mprat99/IoT_Awnings/IoT_Awnings_Electronics_Schematic.pdf

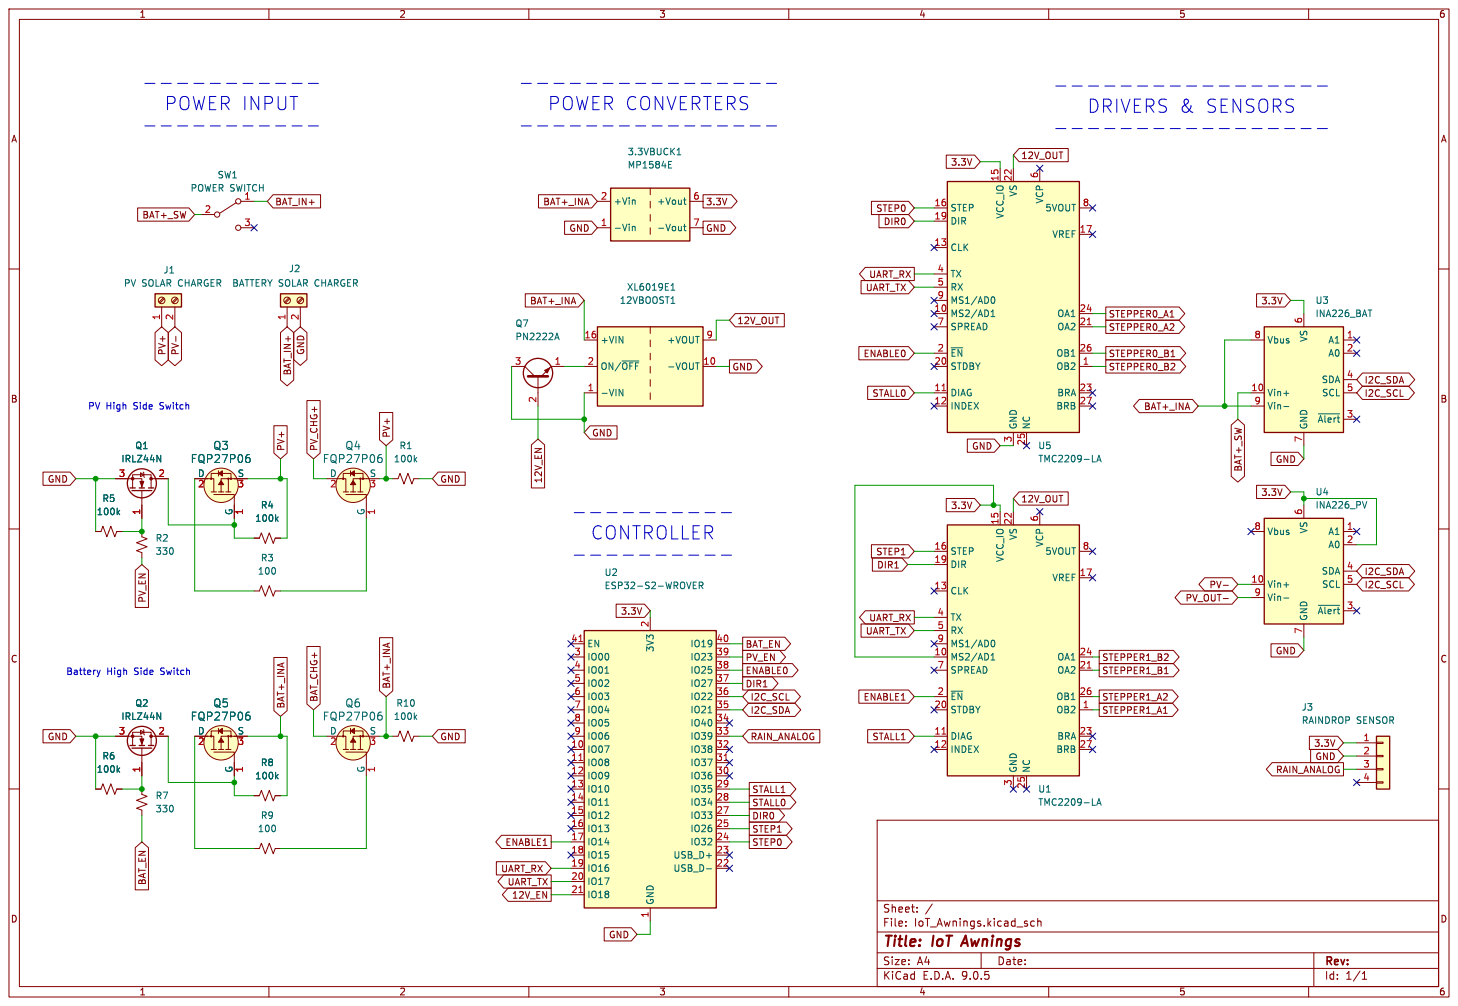
[picture p1: page 1]

STEP 16 DIR 19 CLK 13 TX 4 RX 5 MS1/AD0 9 MS2/AD1 10 SPREAD 7 ~{EN} 2 STDBY 20 DIAG 11

5VOUT 8 VREF 17 OA1 24 OA2 21 OB1 26 OB2 1 BRA 23 BRB 27 U1 TMC2209-LA

Id: 1/1 Title: IoT Awnings
