mprat99/IoT_Awnings/iot_awnings.ino

// =======================
// Includes
// =======================
#include <WiFi.h>
#include <AsyncTCP.h>
#include <ESPAsyncWebServer.h>
#include <time.h>
#include <ArduinoJson.h>
#include <FastAccelStepper.h>
#include <TMCStepper.h>
#include <EEPROM.h>
#include <Preferences.h>
#include <WiFiClient.h>
#include <ESPmDNS.h>
#include <Wire.h>
#include <INA226_WE.h>
#include "LittleFS.h"
#include <Update.h>
#include "esp_log.h"
#include <SolarCalculator.h>
#include <Ticker.h>



// =======================
// Pin Definitions (Updated)
// =======================

// Stepper 0
#define STEP0 32
#define DIR0 33
#define ENABLE0 25
#define STALL0 34
#define UART_ADDR0 0

// Stepper 1
#define STEP1 26
#define DIR1 27
#define ENABLE1 14
#define STALL1 35
#define UART_ADDR1 2

// ESP32 UART pins for TMC UART
#define UART_RX 16
#define UART_TX 17

// Boost converter (XL6019) enable (BJT base)
#define OUTPUT_12V_EN 18

// Solar charger control (kept HIGH, no logic)
#define PV_EN 23
#define BAT_EN 19

// Rain sensor
#define RAIN_PIN 39

// I2C pins
#define I2C_SDA 21
#define I2C_SCL 22

// =======================
// Hardware Configuration
// =======================
#define R_SENSE 0.11f   // TMC2209 sense resistor
uint8_t STALL_VALUE = 60;  // StallGuard threshold
uint8_t LOW_STALL_VALUE = 30;  // StallGuard threshold to avoid stall when no necessary to check
uint32_t STALL_MIN_SPEED = 400;  // StallGuard threshold


HardwareSerial SerialTMC(2);  // UART2 for both drivers

// Two TMC2209 over same UART, different addresses
TMC2209Stepper driver0(&SerialTMC, R_SENSE, UART_ADDR0);
TMC2209Stepper driver1(&SerialTMC, R_SENSE, UART_ADDR1);

TMC2209Stepper driver[] = {driver0, driver1};

// =======================
// FastAccelStepper
// =======================
FastAccelStepperEngine engine;
FastAccelStepper *stepper[2];

// Motion parameters
uint32_t motorSpeed[] = { 7000, 7000 };  // in steps/s
uint32_t acceleration = 2000;  // in steps/s²


// Enable pins (active LOW)
int enablePin[] = { ENABLE0, ENABLE1 };

// =======================
// Motion Control Variables
// =======================
volatile bool moveFlag[] = { false, false };
volatile bool interruptAttached[2] = {true, true};
bool homed[] = { false, false };
uint8_t homingPhase[2] = {0, 0};
unsigned long moveStartMillis[2] = {0, 0};

int targetPosition[] = { 0, 0 };
int currentPosition[] = { 0, 0 };
int beforeRainPosition[] = { 0, 0 };

constexpr uint8_t PRESET_COUNT = 3;
constexpr uint8_t AWNING_COUNT = 2;
struct AwningPreset {
  char name[16];
  uint8_t position[AWNING_COUNT];  // 0 = fully up, 100 = fully down
};

AwningPreset presets[PRESET_COUNT] = {
  { "Open", { 0, 0 } },
  { "Morning Shade", { 40, 40 } },
  { "Afternoon", { 70, 70 } }
};
uint8_t morningPresetIndex = 0;

int windowHeight[] = { 229000, -140500 };
int downPosition[] = { 229000, -140500 };
int maxPosition[] = { 500000, -300000 };

const char *positionReason[] = { "Power On", "Power On" };
char moveTimeStr[2][8] = { "00:00h", "00:00h" };

// =======================
// Network Configuration
// =======================
const char *ssid = "KITCHENWIFI";
const char *password = "RujMfdvc";

const char *apSSID = "Kitchen Awnings";
const char *apPassword = "Croquets";

IPAddress localIp;

IPAddress staticIP(192, 168, 1, 155);  // ESP32 static IP
IPAddress gateway(192, 168, 1, 1);     // Gateway
IPAddress subnet(255, 255, 255, 0);    // Subnet mask
IPAddress primaryDNS(8, 8, 8, 8);      // Primary DNS
IPAddress secondaryDNS(8, 8, 4, 4);    // Secondary DNS

AsyncWebServer server(80);
const char *otaUser = "admin";
const char *otaPassword = "admin";

const int ssidMaxSize = 32;
const int passwordMaxSize = 64;

struct WiFiCredentials {
  char ssid[ssidMaxSize];
  char password[passwordMaxSize];
};
WiFiCredentials credentials;
Preferences preferences;

// =======================
// Timing & Scheduling
// =======================
int morningHour = 7;
int morningMinute = 30;
int nightHour = 21;
int nightMinute = 0;

int currentHour = 0;
int currentMinute = 0;
int currentSecond = 0;

unsigned long currentMillis = 0;
unsigned long checkTimeMillis = 0;
unsigned long checkTimeInterval = 60000;
unsigned long checkRainMillis = 0;
unsigned long checkRainInterval = 5000;
unsigned long apStartTime = 0;
// unsigned long highCPUFreqStart = 0;
unsigned long apTimeout = 20000;
unsigned long lastAPIrequestMillis = 0;
unsigned long lastAPIrequestTimeout = 5000;
// unsigned long highCPUFreqTimeout = 30000;

Ticker restartTimer;

float LATITUDE = 41.6979;
float LONGITUDE = 2.4328;


// Solar charger times
time_t sunriseTime, sunsetTime;
char sunriseStr[6] = "--:--";
char sunsetStr[6] = "--:--";
char chargerStartStr[6] = "--:--";
char chargerStopStr[6] = "--:--";
bool sunTimesCalculatedToday = false;
int lastSunCalcYearDay = -1;
int solarChargerStartOffsetMin = 30;
int solarChargerStopOffsetMin = 30;




// =======================
// State Flags
// =======================
bool initialHome = false;
bool timeSynced = false;
bool rainSwitch = true;
bool scheduledAwnings = true;
bool moveUpMorning = false;
bool moveDownNight = false;
bool homeFlag = false;
bool apModeEnabled = true;
bool rainSensorEnabled = true;
bool solarChargerEnabled = true;
bool solarChargerAuto = true;
bool output12VEnabled = true;
bool bootUpSunCheck = false;
bool mdnsStarted = false;
// bool highCPU          = false;
bool preemptiveFoldTriggered = false;


int rainState = 0;
bool rainFlag = false;

bool settingEnd[] = { false, false };

// Independent stall flags (per motor)
volatile bool stallFlag[] = { false, false };
bool restored_stall_value[] = {true, true };

// =======================
// INA226 measurement
// // =======================
INA226_WE inaBat(0x40);  // Battery V/I
INA226_WE inaPV(0x41);   // PV current

// IMPORTANT: set to your real shunt values if different
float R_SHUNT_BAT = 0.02455f;   // ohms
float R_SHUNT_PV = 0.02436f;  // ohms

unsigned long inaTriggerMillis = 0;
unsigned long inaReadMillis = 0;
bool inaMeasuring = false;
unsigned long inaPeriod = 10000;
unsigned long previousInaPeriod = 10000;

float batteryVoltage = 0.0f;
float batteryCurrent = 0.0f;
float pvCurrent = 0.0f;
float lowVoltageValue = 9.5f;
bool lowVoltage = false;  // Battery under 9V
bool chargerInitialized = false;
bool socInitialized = false;

// --- Voltage → SOC table for 3S Li-ion pack ---
// const int OCV_N = 15;
// const float ocv_pack_volts[OCV_N] = {
//   12.60, 12.45, 12.30, 12.15, 12.00,
//   11.85, 11.70, 11.55, 11.40, 11.25,
//   11.10, 10.80, 10.50,  9.90,  9.00
// };

// const float ocv_pack_soc[OCV_N] = {
//   100.0, 95.0, 90.0, 85.0, 80.0,
//    75.0, 70.0, 65.0, 60.0, 50.0,
//    40.0, 30.0, 20.0, 10.0,  0.0
// };

const int OCV_N = 31;

const float ocv_pack_volts[OCV_N] = {
  12.60, 12.55, 12.50, 12.45, 12.42,  // 100-80%
  12.38, 12.35, 12.32, 12.28, 12.25,  // 78-60%
  12.22, 12.18, 12.15, 12.10, 12.05,  // 58-40%
  12.00, 11.95, 11.88, 11.80, 11.70,  // 38-20%
  11.60, 11.48, 11.35, 11.20, 11.00,  // 18-4%
  10.85, 10.65, 10.40, 10.15, 9.80,   // 3-0.4%
  9.00                                  // 0%
};

const float ocv_pack_soc[OCV_N] = {
  100.0, 97.0, 95.0, 92.0, 90.0,      // 100-90%
  87.0, 85.0, 82.0, 78.0, 75.0,       // 87-75%
  72.0, 68.0, 65.0, 62.0, 58.0,       // 72-58%
  55.0, 52.0, 48.0, 45.0, 40.0,       // 55-40%
  35.0, 30.0, 25.0, 20.0, 15.0,       // 35-15%
  12.0, 8.0, 5.0, 2.0, 0.4,           // 12-0.4%
  0.0                                   // 0%
};

// --- Global variables ---
float batterySoC = 100.0;       // 0–100%
float currentCapacity_mAh = 0.0;       // coulomb counter
const float nominalCapacity_mAh = 3300.0f;
float estimatedCapacity_mAh = nominalCapacity_mAh;
float chargedToday = 0.0f;
float dischargedToday = 0.0f;
float pvToday = 0.0f;
float lastPersistedSoC = -1000.0f;
unsigned long lastSoCPersistMillis = 0;
float lastPersistedChargedToday = 0.0f;
float lastPersistedDischargedToday = 0.0f;
float lastPersistedPvToday = 0.0f;
unsigned long lastEnergyPersistMillis = 0;
bool dailyEnergyStateLoaded = false;
int dailyEnergyDayStamp = -1;
bool capacityLearningFromFull = false;
bool fullChargeLatched = false;
float dischargedSinceFull_mAh = 0.0f;

bool serialDebug = false;

const float PREEMPTIVE_SOC = 25.0f;
const float PREEMPTIVE_SOC_CLEAR = 30.0f;
const float PREEMPTIVE_VOLT = 11.3f;
const float PREEMPTIVE_VOLT_CLEAR = 11.6f;
const float PV_CHARGING_MIN_MA = 20.0f;
const unsigned long SOC_PERSIST_INTERVAL_MS = 10UL * 60UL * 1000UL;
const float SOC_PERSIST_DELTA_PCT = 2.0f;
const float SOC_BOOT_ACCEPT_DELTA_PCT = 5.0f;
const unsigned long BOOT_BATT_SETTLE_MS = 1500;
const uint8_t BOOT_BATT_SAMPLES = 8;
const unsigned long BOOT_BATT_SAMPLE_DELAY_MS = 80;
const float BOOT_BATT_MAX_DELTA_V = 0.05f;
const float BOOT_BATT_MAX_CURRENT_MA = 80.0f;
const unsigned long ENERGY_PERSIST_INTERVAL_MS = 15UL * 60UL * 1000UL;
const float ENERGY_PERSIST_DELTA_MAH = 25.0f;
const float FULL_CHARGE_BMS_VOLTAGE = 16.5f;
const float FULL_CHARGE_CURRENT_MA = 100.0f;
const float FULL_CHARGE_RELEASE_VOLTAGE = 15.0f;
const float CAPACITY_LEARN_MIN_FRACTION = 0.60f;
const float CAPACITY_LEARN_ALPHA = 0.20f;

#define DEBUG_PRINT(x) \
  do { \
    if (serialDebug) Serial.print(x); \
  } while (0)
#define DEBUG_PRINTLN(x) \
  do { \
    if (serialDebug) Serial.println(x); \
  } while (0)
#define DEBUG_PRINTF(format, ...) \
  do { \
    if (serialDebug) Serial.printf(format, __VA_ARGS__); \
  } while (0)

// =======================
// Function Prototypes
// =======================
void checkTime();
void checkRain();
void IRAM_ATTR stallDetected0();
void IRAM_ATTR stallDetected1();

void initCharger();
void connectCharger();
void disconnectCharger();
bool isChargerConnected();
time_t roundTimeToNearestMinute(time_t value);
time_t getChargerStartTime();
time_t getChargerStopTime();
bool isWithinSolarChargingWindow(time_t now);
void formatTimeToHHMM(time_t value, char *buffer, size_t len);
void configureServer();
void connectToWiFi();
void printResetReason();
bool checkInternet();
bool ensureUpdateAuth(AsyncWebServerRequest *request);
void handleFirmwareUpdateUpload(AsyncWebServerRequest *request, String filename, size_t index, uint8_t *data, size_t len, bool final);
void handleFilesystemUpdateUpload(AsyncWebServerRequest *request, String filename, size_t index, uint8_t *data, size_t len, bool final);

void getMoveTimeString();

void home();
void moveUp(uint8_t i);
void moveDown(uint8_t i);
void moveToPosition(uint8_t i, int position);
void moveToPercent(uint8_t i, uint8_t percent);
bool moveToPreset(uint8_t presetIndex, const char *reason);
void stop(uint8_t i);

void enableOutput12V();
void disableOutput12V(bool force);
void checkPreemptiveFold();

void inaSetup();
void inaTrigger();
void inaRead();
float voltageToSoC(float vpack);
bool getStableBootBatteryReading(float &stableVoltage, float &stableCurrent);
void initSocFromBootOrNvm();
void loadPersistedSocState(bool &hasStoredState, float &storedSoc, float &storedCapacity);
void savePersistedSocState(bool force = false);
void updateCapacityLearning(float current_mA, float delta_mAh);
void handleRealFullChargeEvent();
int getCurrentDayStamp(const struct tm &timeInfo);
void ensureDailyEnergyStateLoaded(const struct tm &timeInfo);
void resetDailyEnergyCounters(bool persist = true);
void savePersistedEnergyState(bool force = false);

// HTTP handlers you referenced (kept minimal but functional)
void handleMove(AsyncWebServerRequest *request, uint8_t *data, size_t len, size_t index, size_t total);
void handleSave(AsyncWebServerRequest *request, uint8_t *data, size_t len, size_t index, size_t total);
void handleSetEnd(AsyncWebServerRequest *request, uint8_t *data, size_t len, size_t index, size_t total);
void handlePreset(AsyncWebServerRequest *request, uint8_t *data, size_t len, size_t index, size_t total);
void handleSaveWifi(AsyncWebServerRequest *request, uint8_t *data, size_t len, size_t index, size_t total);
void handleSetupDrivers(AsyncWebServerRequest *request, uint8_t *data, size_t len, size_t index, size_t total);
void handleSetupInas(AsyncWebServerRequest *request, uint8_t *data, size_t len, size_t index, size_t total);
void loadPersistedConfig();
void savePersistedConfig();
void loadWiFiCredentials();
void saveWiFiCredentials();
bool hasStoredWifiCredentials();
bool migrateLegacyWifiCredentials();

void loadPersistedConfig() {
  preferences.begin("cfg", true);
  morningHour = preferences.getInt("mHr", morningHour);
  morningMinute = preferences.getInt("mMin", morningMinute);
  nightHour = preferences.getInt("nHr", nightHour);
  nightMinute = preferences.getInt("nMin", nightMinute);
  scheduledAwnings = preferences.getBool("sched", scheduledAwnings);
  rainSensorEnabled = preferences.getBool("rain", rainSensorEnabled);
  solarChargerEnabled = preferences.getBool("solar", solarChargerEnabled);
  solarChargerAuto = preferences.getBool("solAuto", solarChargerAuto);
  output12VEnabled = preferences.getBool("out12v", output12VEnabled);
  solarChargerStartOffsetMin = preferences.getInt("solSta", solarChargerStartOffsetMin);
  solarChargerStopOffsetMin = preferences.getInt("solStp", solarChargerStopOffsetMin);
  STALL_VALUE = preferences.getUChar("stall", STALL_VALUE);
  LOW_STALL_VALUE = preferences.getUChar("lstall", LOW_STALL_VALUE);
  STALL_MIN_SPEED = preferences.getUInt("stMin", STALL_MIN_SPEED);
  uint32_t legacySpeed = preferences.getUInt("speed", motorSpeed[0]);
  motorSpeed[0] = preferences.getUInt("speed0", legacySpeed);
  motorSpeed[1] = preferences.getUInt("speed1", legacySpeed);
  acceleration = preferences.getUInt("accel", acceleration);
  R_SHUNT_BAT = preferences.getFloat("rBat", R_SHUNT_BAT);
  R_SHUNT_PV = preferences.getFloat("rPv", R_SHUNT_PV);
  downPosition[0] = preferences.getInt("dPos0", downPosition[0]);
  downPosition[1] = preferences.getInt("dPos1", downPosition[1]);
  morningPresetIndex = preferences.getUChar("mPreset", morningPresetIndex);
  for (uint8_t p = 0; p < PRESET_COUNT; p++) {
    char key[8];
    snprintf(key, sizeof(key), "p%un0", p);
    String defaultName = presets[p].name;
    String name = preferences.getString(key, defaultName);
    name.toCharArray(presets[p].name, sizeof(presets[p].name));
    for (uint8_t i = 0; i < AWNING_COUNT; i++) {
      snprintf(key, sizeof(key), "p%up%u", p, i);
      presets[p].position[i] = preferences.getUChar(key, presets[p].position[i]);
    }
  }
  preferences.end();

  windowHeight[0] = downPosition[0];
  windowHeight[1] = downPosition[1];

  morningHour = constrain(morningHour, 0, 23);
  morningMinute = constrain(morningMinute, 0, 59);
  nightHour = constrain(nightHour, 0, 23);
  nightMinute = constrain(nightMinute, 0, 59);
  solarChargerStartOffsetMin = constrain(solarChargerStartOffsetMin, 0, 360);
  solarChargerStopOffsetMin = constrain(solarChargerStopOffsetMin, 0, 360);
  if (STALL_MIN_SPEED < 1) STALL_MIN_SPEED = 1;
  if (motorSpeed[0] < 1) motorSpeed[0] = 1;
  if (motorSpeed[1] < 1) motorSpeed[1] = 1;
  if (acceleration < 1) acceleration = 1;
  if (R_SHUNT_BAT <= 0.0f || R_SHUNT_BAT > 1.0f) R_SHUNT_BAT = 0.02455f;
  if (R_SHUNT_PV <= 0.0f || R_SHUNT_PV > 1.0f) R_SHUNT_PV = 0.02436f;
  if (morningPresetIndex >= PRESET_COUNT) morningPresetIndex = 0;
  for (uint8_t p = 0; p < PRESET_COUNT; p++) {
    for (uint8_t i = 0; i < AWNING_COUNT; i++) {
      presets[p].position[i] = constrain(presets[p].position[i], 0, 100);
    }
  }
}

void savePersistedConfig() {
  preferences.begin("cfg", false);
  preferences.putInt("mHr", morningHour);
  preferences.putInt("mMin", morningMinute);
  preferences.putInt("nHr", nightHour);
  preferences.putInt("nMin", nightMinute);
  preferences.putBool("sched", scheduledAwnings);
  preferences.putBool("rain", rainSensorEnabled);
  preferences.putBool("solar", solarChargerEnabled);
  preferences.putBool("solAuto", solarChargerAuto);
  preferences.putBool("out12v", output12VEnabled);
  preferences.putInt("solSta", solarChargerStartOffsetMin);
  preferences.putInt("solStp", solarChargerStopOffsetMin);
  preferences.putUChar("stall", STALL_VALUE);
  preferences.putUChar("lstall", LOW_STALL_VALUE);
  preferences.putUInt("stMin", STALL_MIN_SPEED);
  preferences.putUInt("speed", motorSpeed[0]);
  preferences.putUInt("speed0", motorSpeed[0]);
  preferences.putUInt("speed1", motorSpeed[1]);
  preferences.putUInt("accel", acceleration);
  preferences.putFloat("rBat", R_SHUNT_BAT);
  preferences.putFloat("rPv", R_SHUNT_PV);
  preferences.putInt("dPos0", downPosition[0]);
  preferences.putInt("dPos1", downPosition[1]);
  preferences.putUChar("mPreset", morningPresetIndex);
  for (uint8_t p = 0; p < PRESET_COUNT; p++) {
    char key[8];
    snprintf(key, sizeof(key), "p%un0", p);
    preferences.putString(key, presets[p].name);
    for (uint8_t i = 0; i < AWNING_COUNT; i++) {
      snprintf(key, sizeof(key), "p%up%u", p, i);
      preferences.putUChar(key, presets[p].position[i]);
    }
  }
  preferences.end();
}

bool hasStoredWifiCredentials() {
  preferences.begin("wifi", true);
  bool hasSsid = preferences.isKey("ssid");
  preferences.end();
  return hasSsid;
}

bool migrateLegacyWifiCredentials() {
  EEPROM.begin(sizeof(WiFiCredentials));
  WiFiCredentials legacyCredentials;
  EEPROM.get(0, legacyCredentials);

  bool validLegacyCredentials =
    legacyCredentials.ssid[0] != 0 &&
    legacyCredentials.ssid[0] != static_cast<char>(0xFF);

  if (validLegacyCredentials) {
    memcpy(&credentials, &legacyCredentials, sizeof(WiFiCredentials));
    credentials.ssid[ssidMaxSize - 1] = 0;
    credentials.password[passwordMaxSize - 1] = 0;
    saveWiFiCredentials();
  }

  EEPROM.end();
  return validLegacyCredentials;
}

void loadWiFiCredentials() {
  memset(&credentials, 0, sizeof(credentials));

  if (hasStoredWifiCredentials()) {
    preferences.begin("wifi", true);
    String storedSsid = preferences.getString("ssid", "");
    String storedPassword = preferences.getString("pass", "");
    preferences.end();

    storedSsid.toCharArray(credentials.ssid, ssidMaxSize);
    storedPassword.toCharArray(credentials.password, passwordMaxSize);
  } else if (!migrateLegacyWifiCredentials()) {
    strncpy(credentials.ssid, ssid, sizeof(credentials.ssid));
    credentials.ssid[ssidMaxSize - 1] = 0;
    strncpy(credentials.password, password, sizeof(credentials.password));
    credentials.password[passwordMaxSize - 1] = 0;
    saveWiFiCredentials();
    Serial.println("Using hardcoded credentials.");
  }
}

void saveWiFiCredentials() {
  preferences.begin("wifi", false);
  preferences.putString("ssid", credentials.ssid);
  preferences.putString("pass", credentials.password);
  preferences.end();
}

void loadPersistedSocState(bool &hasStoredState, float &storedSoc, float &storedCapacity) {
  preferences.begin("soc", true);
  hasStoredState = preferences.getBool("valid", false);
  storedSoc = preferences.getFloat("soc", 0.0f);
  storedCapacity = preferences.getFloat("cap", 0.0f);
  estimatedCapacity_mAh = preferences.getFloat("estCap", nominalCapacity_mAh);
  preferences.end();

  if (estimatedCapacity_mAh < 1000.0f || estimatedCapacity_mAh > (nominalCapacity_mAh * 2.0f)) {
    estimatedCapacity_mAh = nominalCapacity_mAh;
  }

  if (!hasStoredState) {
    return;
  }

  if (storedSoc < 0.0f || storedSoc > 100.0f || storedCapacity < 0.0f || storedCapacity > estimatedCapacity_mAh) {
    hasStoredState = false;
  }
}

bool getStableBootBatteryReading(float &stableVoltage, float &stableCurrent) {
  stableVoltage = 0.0f;
  stableCurrent = 0.0f;

  disconnectCharger();
  digitalWrite(OUTPUT_12V_EN, HIGH);
  delay(BOOT_BATT_SETTLE_MS);

  float voltageSum = 0.0f;
  float currentSum = 0.0f;
  float minVoltage = 1000.0f;
  float maxVoltage = -1000.0f;

  for (uint8_t sample = 0; sample < BOOT_BATT_SAMPLES; sample++) {
    inaBat.startSingleMeasurement();
    delay(12);

    float sampleVoltage = inaBat.getBusVoltage_V();
    float sampleCurrent = -inaBat.getCurrent_mA();

    if (!isfinite(sampleVoltage) || !isfinite(sampleCurrent) || sampleVoltage <= 0.0f || sampleVoltage > 20.0f) {
      return false;
    }

    if (fabs(sampleCurrent) > BOOT_BATT_MAX_CURRENT_MA) {
      return false;
    }

    voltageSum += sampleVoltage;
    currentSum += sampleCurrent;
    if (sampleVoltage < minVoltage) minVoltage = sampleVoltage;
    if (sampleVoltage > maxVoltage) maxVoltage = sampleVoltage;

    delay(BOOT_BATT_SAMPLE_DELAY_MS);
  }

  if ((maxVoltage - minVoltage) > BOOT_BATT_MAX_DELTA_V) {
    return false;
  }

  stableVoltage = voltageSum / BOOT_BATT_SAMPLES;
  stableCurrent = currentSum / BOOT_BATT_SAMPLES;
  return true;
}

void initSocFromBootOrNvm() {
  float stableVoltage = 0.0f;
  float stableCurrent = 0.0f;

  if (!getStableBootBatteryReading(stableVoltage, stableCurrent)) {
    return;
  }

  batteryVoltage = stableVoltage;
  batteryCurrent = stableCurrent;
  pvCurrent = 0.0f;
  lowVoltage = (batteryVoltage < lowVoltageValue);

  float socVoltage = voltageToSoC(stableVoltage);
  if (socVoltage <= 0.0f) {
    return;
  }

  bool hasStoredState = false;
  float storedSoc = 0.0f;
  float storedCapacity = 0.0f;
  loadPersistedSocState(hasStoredState, storedSoc, storedCapacity);

  if (hasStoredState && fabs(storedSoc - socVoltage) <= SOC_BOOT_ACCEPT_DELTA_PCT) {
    batterySoC = storedSoc;
    currentCapacity_mAh = storedCapacity;
  } else {
    batterySoC = socVoltage;
    currentCapacity_mAh = estimatedCapacity_mAh * (socVoltage / 100.0f);
  }

  socInitialized = true;
  lastPersistedSoC = batterySoC;
  if (!hasStoredState) {
    savePersistedSocState(true);
  }
}

void savePersistedSocState(bool force) {
  if (!socInitialized) {
    return;
  }

  if (!force) {
    if ((currentMillis - lastSoCPersistMillis) < SOC_PERSIST_INTERVAL_MS) {
      return;
    }
    if (fabs(batterySoC - lastPersistedSoC) < SOC_PERSIST_DELTA_PCT) {
      return;
    }
  }

  preferences.begin("soc", false);
  preferences.putBool("valid", true);
  preferences.putFloat("soc", batterySoC);
  preferences.putFloat("cap", currentCapacity_mAh);
  preferences.putFloat("estCap", estimatedCapacity_mAh);
  preferences.end();

  lastPersistedSoC = batterySoC;
  lastSoCPersistMillis = currentMillis;
}

void handleRealFullChargeEvent() {
  if (capacityLearningFromFull &&
      dischargedSinceFull_mAh >= (estimatedCapacity_mAh * CAPACITY_LEARN_MIN_FRACTION)) {
    estimatedCapacity_mAh =
      ((1.0f - CAPACITY_LEARN_ALPHA) * estimatedCapacity_mAh) +
      (CAPACITY_LEARN_ALPHA * dischargedSinceFull_mAh);
  }

  currentCapacity_mAh = estimatedCapacity_mAh;
  batterySoC = 100.0f;
  socInitialized = true;
  capacityLearningFromFull = true;
  dischargedSinceFull_mAh = 0.0f;
  savePersistedSocState(true);
}

void updateCapacityLearning(float current_mA, float delta_mAh) {
  bool bmsFullDetected =
    isChargerConnected() &&
    batteryVoltage >= FULL_CHARGE_BMS_VOLTAGE &&
    fabs(current_mA) <= FULL_CHARGE_CURRENT_MA;

  if (bmsFullDetected && !fullChargeLatched) {
    handleRealFullChargeEvent();
    fullChargeLatched = true;
  } else if (!bmsFullDetected && batteryVoltage < FULL_CHARGE_RELEASE_VOLTAGE) {
    fullChargeLatched = false;
  }

  if (capacityLearningFromFull && delta_mAh < 0.0f) {
    dischargedSinceFull_mAh += -delta_mAh;
  }

  if (capacityLearningFromFull && lowVoltage &&
      dischargedSinceFull_mAh >= (estimatedCapacity_mAh * CAPACITY_LEARN_MIN_FRACTION)) {
    estimatedCapacity_mAh =
      ((1.0f - CAPACITY_LEARN_ALPHA) * estimatedCapacity_mAh) +
      (CAPACITY_LEARN_ALPHA * dischargedSinceFull_mAh);
    capacityLearningFromFull = false;
    dischargedSinceFull_mAh = 0.0f;
    savePersistedSocState(true);
  }
}

int getCurrentDayStamp(const struct tm &timeInfo) {
  return ((timeInfo.tm_year + 1900) * 1000) + timeInfo.tm_yday;
}

void resetDailyEnergyCounters(bool persist) {
  chargedToday = 0.0f;
  dischargedToday = 0.0f;
  pvToday = 0.0f;
  lastPersistedChargedToday = 0.0f;
  lastPersistedDischargedToday = 0.0f;
  lastPersistedPvToday = 0.0f;

  if (persist && dailyEnergyStateLoaded && dailyEnergyDayStamp >= 0) {
    savePersistedEnergyState(true);
  }
}

void ensureDailyEnergyStateLoaded(const struct tm &timeInfo) {
  int currentDayStamp = getCurrentDayStamp(timeInfo);

  if (dailyEnergyStateLoaded && dailyEnergyDayStamp == currentDayStamp) {
    return;
  }

  preferences.begin("energy", true);
  bool valid = preferences.getBool("valid", false);
  int storedDayStamp = preferences.getInt("day", -1);
  float storedCharged = preferences.getFloat("chg", 0.0f);
  float storedDischarged = preferences.getFloat("dchg", 0.0f);
  float storedPv = preferences.getFloat("pv", 0.0f);
  preferences.end();

  dailyEnergyDayStamp = currentDayStamp;
  dailyEnergyStateLoaded = true;

  if (valid && storedDayStamp == currentDayStamp &&
      storedCharged >= 0.0f && storedDischarged >= 0.0f && storedPv >= 0.0f) {
    chargedToday = storedCharged;
    dischargedToday = storedDischarged;
    pvToday = storedPv;
    lastPersistedChargedToday = storedCharged;
    lastPersistedDischargedToday = storedDischarged;
    lastPersistedPvToday = storedPv;
    return;
  }

  resetDailyEnergyCounters(false);
  savePersistedEnergyState(true);
}

void savePersistedEnergyState(bool force) {
  if (!dailyEnergyStateLoaded || dailyEnergyDayStamp < 0) {
    return;
  }

  if (!force) {
    if ((currentMillis - lastEnergyPersistMillis) < ENERGY_PERSIST_INTERVAL_MS) {
      return;
    }

    bool chargedChanged = fabs(chargedToday - lastPersistedChargedToday) >= ENERGY_PERSIST_DELTA_MAH;
    bool dischargedChanged = fabs(dischargedToday - lastPersistedDischargedToday) >= ENERGY_PERSIST_DELTA_MAH;
    bool pvChanged = fabs(pvToday - lastPersistedPvToday) >= ENERGY_PERSIST_DELTA_MAH;
    if (!chargedChanged && !dischargedChanged && !pvChanged) {
      return;
    }
  }

  preferences.begin("energy", false);
  preferences.putBool("valid", true);
  preferences.putInt("day", dailyEnergyDayStamp);
  preferences.putFloat("chg", chargedToday);
  preferences.putFloat("dchg", dischargedToday);
  preferences.putFloat("pv", pvToday);
  preferences.end();

  lastPersistedChargedToday = chargedToday;
  lastPersistedDischargedToday = dischargedToday;
  lastPersistedPvToday = pvToday;
  lastEnergyPersistMillis = currentMillis;
}

void setupDrivers() {
  driver[0].begin();
  driver[0].toff(4);
  driver[0].blank_time(24);
  driver[0].rms_current(1600);
  driver[0].microsteps(16);
  driver[0].en_spreadCycle(false);
  driver[0].pwm_autoscale(true);
  driver[0].TCOOLTHRS(STALL_MIN_SPEED);
  driver[0].SGTHRS(STALL_VALUE);

  driver[1].begin();
  driver[1].toff(4);
  driver[1].blank_time(24);
  driver[1].rms_current(1600);
  driver[1].microsteps(16);
  driver[1].en_spreadCycle(false);
  driver[1].pwm_autoscale(true);
  driver[1].TCOOLTHRS(STALL_MIN_SPEED);
  driver[1].SGTHRS(STALL_VALUE);
}

void setupSteppers() {
  pinMode(ENABLE0, OUTPUT);
  pinMode(ENABLE1, OUTPUT);
  digitalWrite(ENABLE0, HIGH);
  digitalWrite(ENABLE1, HIGH);

  pinMode(STEP0, OUTPUT);
  pinMode(DIR0, OUTPUT);
  pinMode(STALL0, INPUT);
  pinMode(STEP1, OUTPUT);
  pinMode(DIR1, OUTPUT);
  pinMode(STALL1, INPUT);

  engine.init();

  stepper[0] = engine.stepperConnectToPin(STEP0);
  stepper[1] = engine.stepperConnectToPin(STEP1);

  stepper[0]->setDirectionPin(DIR0);
  stepper[0]->setEnablePin(ENABLE0, true);
  stepper[0]->setSpeedInHz(motorSpeed[0]);
  stepper[0]->setAcceleration(acceleration);
  stepper[0]->setAutoEnable(true);

  stepper[1]->setDirectionPin(DIR1);
  stepper[1]->setEnablePin(ENABLE1, true);
  stepper[1]->setSpeedInHz(motorSpeed[1]);
  stepper[1]->setAcceleration(acceleration);
  stepper[1]->setAutoEnable(true);
}

// =======================
// Setup
// =======================
void setup() {

  if (serialDebug) {
    Serial.begin(115200);
    Serial.setDebugOutput(true);
    delay(200);
  }

  esp_log_level_set("i2c.master", ESP_LOG_NONE);
  loadPersistedConfig();
  loadWiFiCredentials();

  // Pins
  pinMode(OUTPUT_12V_EN, OUTPUT);
  digitalWrite(OUTPUT_12V_EN, HIGH);  // motors power OFF initially


  pinMode(BAT_EN, OUTPUT);
  digitalWrite(BAT_EN, HIGH);

  pinMode(PV_EN, OUTPUT);
  digitalWrite(PV_EN, HIGH);

  pinMode(RAIN_PIN, INPUT);


  // I2C
  Wire.begin(I2C_SDA, I2C_SCL);
  inaSetup();
  initSocFromBootOrNvm();
  enableOutput12V();

  // UART for TMC2209
  SerialTMC.begin(115200, SERIAL_8N1, UART_RX, UART_TX);

  setupDrivers();
  setupSteppers();
  delay(500);

  // Reset reason
  printResetReason();

  delay(100);

  // Stall interrupts per motor
  attachInterrupt(digitalPinToInterrupt(STALL0), stallDetected0, RISING);
  attachInterrupt(digitalPinToInterrupt(STALL1), stallDetected1, RISING);

  // Initial INA read
  inaTrigger();
  delay(9);
  inaRead();

  if (!lowVoltage) {
    initCharger();
    home();
    checkRain();
  }

  if (!output12VEnabled && !moveFlag[0] && !moveFlag[1]) {
    disableOutput12V(false);
  }

  if (!LittleFS.begin()) {
    DEBUG_PRINTLN("An Error has occurred while mounting LittleFS");
    return;
  }

  connectToWiFi();
  delay(150);
  configureServer();
  delay(150);
  server.begin();

  // Disable Bluetooth
  btStop();
}

// =======================
// Web Server Routes
// =======================
void configureServer() {

  // ------------------------------
  // Serve main page
  // ------------------------------
  server.on("/", HTTP_GET, [](AsyncWebServerRequest *request) {
    inaPeriod = 2000;
    previousInaPeriod = inaPeriod;
    inaRead();
    request->send(LittleFS, "/index.html", "text/html");
  });

  // ------------------------------
  // Serve CSS
  // ------------------------------
  server.on("/style.css", HTTP_GET, [](AsyncWebServerRequest *request) {
    request->send(LittleFS, "/style.css", "text/css");
  });

  server.on("/update", HTTP_GET, [](AsyncWebServerRequest *request) {
    if (!ensureUpdateAuth(request)) {
      return;
    }
    request->send(LittleFS, "/update.html", "text/html");
  });

  server.on("/update.html", HTTP_GET, [](AsyncWebServerRequest *request) {
    if (!ensureUpdateAuth(request)) {
      return;
    }
    request->send(LittleFS, "/update.html", "text/html");
  });

  server.on(
    "/update/firmware", HTTP_POST,
    [](AsyncWebServerRequest *request) {
      if (!ensureUpdateAuth(request)) {
        return;
      }

      bool success = !Update.hasError();
      request->send(success ? 200 : 500, "text/plain", success ? "Firmware update OK. Rebooting..." : "Firmware update failed");
      if (success) {
        restartTimer.once(1.0, scheduleRestart);
      }
    },
    handleFirmwareUpdateUpload);

  server.on(
    "/update/filesystem", HTTP_POST,
    [](AsyncWebServerRequest *request) {
      if (!ensureUpdateAuth(request)) {
        return;
      }

      bool success = !Update.hasError();
      request->send(success ? 200 : 500, "text/plain", success ? "Filesystem update OK. Rebooting..." : "Filesystem update failed");
      if (success) {
        restartTimer.once(1.0, scheduleRestart);
      }
    },
    handleFilesystemUpdateUpload);

  // ------------------------------
  // Serve sensor/data JSON
  // ------------------------------
  server.on("/data", HTTP_GET, [](AsyncWebServerRequest *request) {
    inaRead();
    lastAPIrequestMillis = currentMillis;
    
    float awning0Percent = 100.0f * ((float)stepper[0]->getCurrentPosition()) / ((float)windowHeight[0]);
    float awning1Percent = 100.0f * ((float)stepper[1]->getCurrentPosition()) / ((float)windowHeight[1]);
    int dist0 = stepper[0]->targetPos() - stepper[0]->getCurrentPosition();
    int dist1 = stepper[1]->targetPos() - stepper[1]->getCurrentPosition();
    StaticJsonDocument<768> doc;
    doc["batteryVoltage"]      = batteryVoltage;
    doc["batteryCurrent"]      = batteryCurrent;
    doc["currentCapacity_mAh"] = currentCapacity_mAh;
    doc["estimatedCapacity_mAh"] = estimatedCapacity_mAh;
    doc["batterySoC"]          = batterySoC;
    doc["chargedToday"]        = chargedToday;
    doc["dischargedToday"]     = dischargedToday;
    doc["pvToday"]             = pvToday;
    doc["pvCurrent"]           = pvCurrent;
    doc["chargerConnected"]    = isChargerConnected();
    doc["pos0"]                = stepper[0]->getCurrentPosition();
    doc["pos1"]                = stepper[1]->getCurrentPosition();
    doc["dist0"]               = dist0;
    doc["dist1"]               = dist1;
    doc["awning0Percent"]      = awning0Percent;
    doc["awning1Percent"]      = awning1Percent;
    doc["motorSpeed0"]         = motorSpeed[0];
    doc["motorSpeed1"]         = motorSpeed[1];
    doc["homeFlag"]            = homeFlag;
    doc["raining"]             = !rainState;

    char json[768];
    serializeJson(doc, json, sizeof(json));
    request->send(200, "application/json", json);
  });


  server.on("/config", HTTP_GET, [](AsyncWebServerRequest *request) {
    
  StaticJsonDocument<1536> doc;

  doc["currentHour"]         = currentHour;
  doc["currentMinute"]       = currentMinute;
  doc["currentSecond"]       = currentSecond;
  doc["moveUpMorning"]       = moveUpMorning;
  doc["moveDownNight"]       = moveDownNight;
  doc["automaticDayNight"]   = scheduledAwnings;
  doc["morningHour"]         = morningHour;
  doc["morningMinute"]       = morningMinute;
  doc["nightHour"]           = nightHour;
  doc["nightMinute"]         = nightMinute;
  doc["rainSensorEnabled"]   = rainSensorEnabled;
  doc["output12VEnabled"]    = !digitalRead(OUTPUT_12V_EN);
  doc["solarChargerEnabled"] = solarChargerEnabled;
  doc["solarChargerAuto"]    = solarChargerAuto;
  doc["chargerConnected"]    = isChargerConnected();
  doc["solarChargerStartOffsetMin"] = solarChargerStartOffsetMin;
  doc["solarChargerStopOffsetMin"]  = solarChargerStopOffsetMin;
  doc["motorSpeed0"]         = motorSpeed[0];
  doc["motorSpeed1"]         = motorSpeed[1];
  doc["travelSteps0"]        = abs(windowHeight[0]);
  doc["travelSteps1"]        = abs(windowHeight[1]);
  doc["morningPresetIndex"]  = morningPresetIndex;
  JsonArray presetArray = doc.createNestedArray("presets");
  for (uint8_t p = 0; p < PRESET_COUNT; p++) {
    JsonObject preset = presetArray.createNestedObject();
    preset["name"] = presets[p].name;
    preset["awning0Percent"] = presets[p].position[0];
    preset["awning1Percent"] = presets[p].position[1];
  }

  char sunriseBuf[16];
  snprintf(sunriseBuf, sizeof(sunriseBuf), "%sh", sunriseStr);
  doc["sunrise"] = sunriseBuf;

  char sunsetBuf[16];
  snprintf(sunsetBuf, sizeof(sunsetBuf), "%sh", sunsetStr);
  doc["sunset"] = sunsetBuf;

  char chargerStartBuf[16];
  snprintf(chargerStartBuf, sizeof(chargerStartBuf), "%sh", chargerStartStr);
  doc["chargerStart"] = chargerStartBuf;

  char chargerStopBuf[16];
  snprintf(chargerStopBuf, sizeof(chargerStopBuf), "%sh", chargerStopStr);
  doc["chargerStop"] = chargerStopBuf;

  doc["timeSynced"]       = timeSynced;
  doc["positionReason0"]  = positionReason[0];   
  doc["positionReason1"]  = positionReason[1];
  doc["moveTime0"]        = moveTimeStr[0];    
  doc["moveTime1"]        = moveTimeStr[1];

  char json[1536];
  serializeJson(doc, json, sizeof(json));
  request->send(200, "application/json", json);
  });

  server.on(
    "/move", HTTP_POST,
    [](AsyncWebServerRequest *request) {
    },
    NULL,  // No upload handler needed
    handleMove);

  server.on(
    "/saveConfig", HTTP_POST,
    [](AsyncWebServerRequest *request) {
    },
    NULL,
    handleSave);

  server.on("/solarOffsets", HTTP_GET, [](AsyncWebServerRequest *request) {
    StaticJsonDocument<256> doc;
    doc["solarChargerStartOffsetMin"] = solarChargerStartOffsetMin;
    doc["solarChargerStopOffsetMin"] = solarChargerStopOffsetMin;

    char chargerStartBuf[16];
    snprintf(chargerStartBuf, sizeof(chargerStartBuf), "%sh", chargerStartStr);
    doc["chargerStart"] = chargerStartBuf;

    char chargerStopBuf[16];
    snprintf(chargerStopBuf, sizeof(chargerStopBuf), "%sh", chargerStopStr);
    doc["chargerStop"] = chargerStopBuf;

    char json[256];
    serializeJson(doc, json, sizeof(json));
    request->send(200, "application/json", json);
  });

  server.on("/wifiScan", HTTP_GET, [](AsyncWebServerRequest *request) {
    lastAPIrequestMillis = currentMillis;

    int networkCount = WiFi.scanNetworks(false, true);
    DynamicJsonDocument doc(2048);
    JsonArray networks = doc.createNestedArray("networks");

    for (int i = 0; i < networkCount; i++) {
      String networkSsid = WiFi.SSID(i);
      if (networkSsid.length() == 0) {
        continue;
      }

      JsonObject network = networks.createNestedObject();
      network["ssid"] = networkSsid;
      network["rssi"] = WiFi.RSSI(i);
      network["secure"] = WiFi.encryptionType(i) != WIFI_AUTH_OPEN;
    }

    WiFi.scanDelete();

    String response;
    serializeJson(doc, response);
    request->send(200, "application/json", response);
  });

  server.on(
    "/solarOffsets", HTTP_POST,
    [](AsyncWebServerRequest *request) {
    },
    NULL,
    handleSave);

  server.on(
    "/setEndPosition", HTTP_POST,
    [](AsyncWebServerRequest *request) {
    },
    NULL,
    handleSetEnd);

  server.on(
    "/preset", HTTP_POST,
    [](AsyncWebServerRequest *request) {
    },
    NULL,
    handlePreset);

  server.on(
    "/saveWifi", HTTP_POST,
    [](AsyncWebServerRequest *request) {
    },
    NULL,
    handleSaveWifi);

  server.on(
    "/setupDrivers", HTTP_POST,
    [](AsyncWebServerRequest *request) {
    },
    NULL,
    handleSetupDrivers);

  server.on(
    "/setupInas", HTTP_POST,
    [](AsyncWebServerRequest *request) {
    },
    NULL,
    handleSetupInas);

  // ------------------------------
  // Special POST route without body
  // ------------------------------
  server.on("/setHome", HTTP_POST, [](AsyncWebServerRequest *request) {
    positionReason[0] = "Home Button";
    positionReason[1] = "Home Button";
    home();
    request->send(200, "text/plain", "Homing");
  });

  server.on("/reset", HTTP_POST, [](AsyncWebServerRequest *request) {
    request->send(200, "text/plain", "Restarting ESP32");
    restartTimer.once(1.0, scheduleRestart); 
  });
}

void scheduleRestart() {
  ESP.restart();
}

bool ensureUpdateAuth(AsyncWebServerRequest *request) {
  if (request->authenticate(otaUser, otaPassword)) {
    return true;
  }

  request->requestAuthentication();
  return false;
}

void handleFirmwareUpdateUpload(AsyncWebServerRequest *request, String filename, size_t index, uint8_t *data, size_t len, bool final) {
  if (!request->authenticate(otaUser, otaPassword)) {
    if (index == 0) {
      request->requestAuthentication();
    }
    return;
  }

  if (index == 0) {
    DEBUG_PRINTF("OTA firmware upload start: %s\n", filename.c_str());
    if (!Update.begin(UPDATE_SIZE_UNKNOWN, U_FLASH)) {
      Update.printError(Serial);
    }
  }

  if (len > 0 && Update.write(data, len) != len) {
    Update.printError(Serial);
  }

  if (final) {
    if (Update.end(true)) {
      DEBUG_PRINTF("OTA firmware upload complete: %s, %u bytes\n", filename.c_str(), index + len);
    } else {
      Update.printError(Serial);
    }
  }
}

void handleFilesystemUpdateUpload(AsyncWebServerRequest *request, String filename, size_t index, uint8_t *data, size_t len, bool final) {
  if (!request->authenticate(otaUser, otaPassword)) {
    if (index == 0) {
      request->requestAuthentication();
    }
    return;
  }

  if (index == 0) {
    DEBUG_PRINTF("OTA filesystem upload start: %s\n", filename.c_str());
    LittleFS.end();
    if (!Update.begin(UPDATE_SIZE_UNKNOWN, U_SPIFFS)) {
      Update.printError(Serial);
    }
  }

  if (len > 0 && Update.write(data, len) != len) {
    Update.printError(Serial);
  }

  if (final) {
    if (Update.end(true)) {
      DEBUG_PRINTF("OTA filesystem upload complete: %s, %u bytes\n", filename.c_str(), index + len);
    } else {
      Update.printError(Serial);
    }
  }
}

// =======================
// Interrupts
// =======================
void IRAM_ATTR stallDetected0() {
  stallFlag[0] = true;
  detachInterrupt(digitalPinToInterrupt(STALL0));
}
void IRAM_ATTR stallDetected1() {
  stallFlag[1] = true;
  detachInterrupt(digitalPinToInterrupt(STALL1));
}



// =======================
// Helpers
// =======================
void initCharger() {
  disconnectCharger();
  delay(1000);
  if (solarChargerAuto) {
    if (isWithinSolarChargingWindow(time(nullptr))) {
      connectCharger();
    }
  } else if (solarChargerEnabled) {
    connectCharger();
  }
  chargerInitialized = true;
}

void connectCharger() {
  digitalWrite(BAT_EN, LOW);
  delay(500);
  digitalWrite(PV_EN, LOW);
}

void disconnectCharger() {
  digitalWrite(PV_EN, HIGH);
  delay(500);
  digitalWrite(BAT_EN, HIGH);
}

bool isChargerConnected() {
  return digitalRead(BAT_EN) == LOW && digitalRead(PV_EN) == LOW;
}

time_t roundTimeToNearestMinute(time_t value) {
  return ((value + 30) / 60) * 60;
}

time_t getChargerStartTime() {
  return sunriseTime + (solarChargerStartOffsetMin * 60);
}

time_t getChargerStopTime() {
  return sunsetTime - (solarChargerStopOffsetMin * 60);
}

bool isWithinSolarChargingWindow(time_t now) {
  time_t chargerStartTime = getChargerStartTime();
  time_t chargerStopTime = getChargerStopTime();
  if (chargerStartTime >= chargerStopTime) {
    return false;
  }
  return now >= chargerStartTime && now <= chargerStopTime;
}

void formatTimeToHHMM(time_t value, char *buffer, size_t len) {
  struct tm timeInfo;
  localtime_r(&value, &timeInfo);
  snprintf(buffer, len, "%02d:%02d", timeInfo.tm_hour, timeInfo.tm_min);
}

void getMoveTimeString(char *buffer, size_t len) {
  snprintf(buffer, len, "%02d:%02dh", currentHour, currentMinute);
}

void enableOutput12V() {
  digitalWrite(OUTPUT_12V_EN, LOW);
}

void disableOutput12V(bool force) {
  // only power off if both motors idle and disabled (unless forced)
  if (force || (!moveFlag[0] && !moveFlag[1])) {
    digitalWrite(ENABLE0, HIGH);  // Not necessary with autoenable but just in case there is a delay
    digitalWrite(ENABLE1, HIGH);
    digitalWrite(OUTPUT_12V_EN, HIGH);
    inaPeriod = previousInaPeriod;
  }
}


void home() {
  homeFlag = true;
  for (uint8_t i = 0; i < 2; i++) {
    if (stepper[i]->isRunning()) {
      stepper[i]->stopMove();
    }

    homed[i] = false;
    moveFlag[i] = true;
    homingPhase[i] = 0;  // Start at phase 0
    uint32_t homingSpeed = motorSpeed[i] / 2;
    stepper[i]->setSpeedInHz(homingSpeed > 0 ? homingSpeed : 1);
  }
}

void handleMove(AsyncWebServerRequest *request, uint8_t *data, size_t len, size_t index, size_t total) {
  DynamicJsonDocument json(1024);
  DeserializationError err = deserializeJson(json, data, len);
  if (err) {
    request->send(400, "text/plain", "Bad JSON");
    return;
  }
  const char *buttonId = json["buttonId"];
  if (!buttonId) {
    request->send(400, "text/plain", "Missing buttonId");
    return;
  }

  int i = (buttonId[strlen(buttonId) - 1] == '0') ? 0 : 1;

  if (i < 0 || i >= 2) {
    request->send(400, "text/plain", "Invalid motor index");
    return;
  }

  positionReason[i] = "Remote button";

  if (strstr(buttonId, "up") != NULL) {
    moveUp(i);
    request->send(200, "text/plain", "Moving up");
  } else if (strstr(buttonId, "stop") != NULL) {
    stop(i);
    request->send(200, "text/plain", "Stopping");
  } else if (strstr(buttonId, "down") != NULL) {
    moveDown(i);
    request->send(200, "text/plain", "Moving down");
  } else {
    request->send(400, "text/plain", "Unknown command");
  }
}

void moveUp(uint8_t i) {
  currentPosition[i] = stepper[i]->getCurrentPosition();
  targetPosition[i] = 0;
  move(i);
}

void stop(uint8_t i) {
  stepper[i]->forceStop();
  delay(20); //forceStop needs about 20ms
  currentPosition[i] = stepper[i]->getCurrentPosition();
  targetPosition[i] = currentPosition[i];
  moveFlag[i] = false;
}

void moveDown(uint8_t i) {
  currentPosition[i] = stepper[i]->getCurrentPosition();
  targetPosition[i] = settingEnd[i] ? maxPosition[i] : downPosition[i];
  move(i);
}

void moveToPosition(uint8_t i, int position) {
  currentPosition[i] = stepper[i]->getCurrentPosition();
  int low = min(0, windowHeight[i]);
  int high = max(0, windowHeight[i]);
  targetPosition[i] = constrain(position, low, high);
  move(i);
}

void moveToPercent(uint8_t i, uint8_t percent) {
  percent = constrain(percent, 0, 100);
  int target = (int)(((int64_t)windowHeight[i] * percent) / 100);
  moveToPosition(i, target);
}

bool moveToPreset(uint8_t presetIndex, const char *reason) {
  if (presetIndex >= PRESET_COUNT || !initialHome || homeFlag || moveFlag[0] || moveFlag[1]) {
    return false;
  }

  for (uint8_t i = 0; i < AWNING_COUNT; i++) {
    moveToPercent(i, presets[presetIndex].position[i]);
    positionReason[i] = reason;
  }
  return true;
}

void move(uint8_t i) {
  detachInterrupt(digitalPinToInterrupt(i == 0 ? STALL0 : STALL1));
  interruptAttached[i] = false;
  
  if (digitalRead(OUTPUT_12V_EN) == HIGH) {
            enableOutput12V();
    delay(50);
  }
  setupDrivers();
  if (!homeFlag) {
    driver[i].SGTHRS(LOW_STALL_VALUE);
    restored_stall_value[i] = false;
  }
  moveFlag[i] = true;
  stepper[i]->setCurrentPosition(currentPosition[i]);
  stepper[i]->moveTo(targetPosition[i]);
  getMoveTimeString(moveTimeStr[i], sizeof(moveTimeStr[i]));
  moveStartMillis[i] = millis();
}

void checkMotors() {
  for (uint8_t i = 0; i < 2; i++) {
    if (inaPeriod != 1000 && stepper[i]->isRunning()) {
      inaPeriod = 1000;
    }
    if (moveFlag[i] && (currentMillis - moveStartMillis[i] > 200)) {
          if (!interruptAttached[i]) {
              attachInterrupt(i == 0 ? digitalPinToInterrupt(STALL0) : digitalPinToInterrupt(STALL1),
                              i == 0 ? stallDetected0 : stallDetected1,
                              RISING);
              interruptAttached[i] = true;
          }
      }
    // --- Stall threshold adjustment ---
    if (moveFlag[i] && !homeFlag && !restored_stall_value[i] &&
        (abs(stepper[i]->targetPos() - stepper[i]->getCurrentPosition()) < 5000 ||
          stepper[i]->getCurrentPosition() > 5000)) {
        driver[i].SGTHRS(STALL_VALUE);
        restored_stall_value[i] = true;
    } 

  // Handle stall detection
    if (stallFlag[i]) {
      stepper[i]->forceStop();
      stallFlag[i] = false;

      // Stall during Phase 2 means we've hit home
      if (homeFlag && homingPhase[i] == 2) {
        stepper[i]->setCurrentPosition(0);
        currentPosition[i] = 0;

        // Phase 3: move slightly away from stall zone
        targetPosition[i] = (i == 0) ? 3000 : -650;
        move(i);
        homingPhase[i] = 3;
      }
    }

  // Homing logic
  if (moveFlag[i] && !stepper[i]->isRunning() && currentMillis - moveStartMillis[i] > 20) {
    if (homeFlag) {
      switch (homingPhase[i]) {
        case 0: // Phase 0: pre-homing descent
          currentPosition[i] = downPosition[i];
          stepper[i]->setCurrentPosition(currentPosition[i]);
          targetPosition[i] = (i == 0) ? currentPosition[i] + 5000 : currentPosition[i] - 5000;
          move(i);
          homingPhase[i] = 1;
          break;

        case 1: // Phase 1: move to 0 and wait for stall
          currentPosition[i] = stepper[i]->getCurrentPosition();
          targetPosition[i] = 0;
          move(i);
          homingPhase[i] = 2;
          break;

        case 3: // Phase 3: post-homing offset complete
          homed[i] = true;
          moveFlag[i] = false;
          currentPosition[i] = 0;
          stepper[i]->setCurrentPosition(currentPosition[i]);
          stepper[i]->setSpeedInHz(motorSpeed[i]);
          if (homed[0] && homed[1]) {
              homeFlag = false;
              initialHome = true;
              disableOutput12V(false);
          }
          break;
      }
    } else {
      moveFlag[i] = false;
      }

      currentPosition[i] = stepper[i]->getCurrentPosition();
      disableOutput12V(false);
      }
  }
}

void checkPreemptiveFold() {
  if (!initialHome || homeFlag) {
    return;
  }
  if (moveFlag[0] || moveFlag[1]) {
    return;
  }

  bool charging = isChargerConnected() && (pvCurrent > PV_CHARGING_MIN_MA);
  bool lowSoon = (batterySoC <= PREEMPTIVE_SOC) || (batteryVoltage <= PREEMPTIVE_VOLT);
  bool recovered = (batterySoC >= PREEMPTIVE_SOC_CLEAR) && (batteryVoltage >= PREEMPTIVE_VOLT_CLEAR);

  if (preemptiveFoldTriggered) {
    if (charging || recovered) {
      preemptiveFoldTriggered = false;
    }
    return;
  }

  if (!charging && lowSoon) {
    bool moved = false;
    for (uint8_t i = 0; i < 2; i++) {
      if (abs(currentPosition[i]) > 1000) {
        moveUp(i);
        positionReason[i] = "Low Battery Fold";
        moved = true;
      }
    }
    if (moved) {
      preemptiveFoldTriggered = true;
    }
  }
}

// =======================
// INA226 Setup & Non-blocking Trigger/Read
// =======================
void inaSetup() {
  // Battery INA
  if (!inaBat.init()) {
    DEBUG_PRINTLN("INA226 battery init failed!");
  }
  inaBat.setAverage(INA226_AVERAGE_4);
  inaBat.setConversionTime(INA226_CONV_TIME_1100);  // ~8.2ms
  inaBat.setMeasureMode(INA226_TRIGGERED);
  inaBat.setResistorRange(R_SHUNT_BAT, 4.0f);

  // PV INA
  if (!inaPV.init()) {
    DEBUG_PRINTLN("INA226 PV init failed!");
  }
  inaPV.setAverage(INA226_AVERAGE_4);
  inaPV.setConversionTime(INA226_CONV_TIME_1100);
  inaPV.setMeasureMode(INA226_TRIGGERED);
  inaPV.setResistorRange(R_SHUNT_PV, 4.0f);
}

void inaTrigger() {
  inaBat.startSingleMeasurement();
  inaPV.startSingleMeasurement();
  inaTriggerMillis = currentMillis;
  inaMeasuring = true;
}

void inaRead() {
  batteryVoltage = inaBat.getBusVoltage_V();
  batteryCurrent = - inaBat.getCurrent_mA();
  pvCurrent = - inaPV.getCurrent_mA();
  if (!isChargerConnected()) {
    pvCurrent = 0.0f;
  }
  lowVoltage = (batteryVoltage < lowVoltageValue);
  if (lowVoltage) {
    lowVoltageValue = 11.0f;
  }
  else {
    lowVoltageValue = 9.5f;
  }

  float dt_s = (currentMillis - inaReadMillis) / 1000.0;

  if (pvCurrent > 0) {
    float delta_pv_mAh = pvCurrent * dt_s / 3600.0;
    pvToday += delta_pv_mAh;
  }
  
  // update SoC
  updateSoC(batteryVoltage, batteryCurrent, dt_s);
  savePersistedEnergyState();
  inaReadMillis = currentMillis;
  inaMeasuring = false;
}

// --- Function to convert voltage to SoC (pack level) ---
float voltageToSoC(float vpack) {
  if (vpack >= ocv_pack_volts[0]) return ocv_pack_soc[0];
  if (vpack <= ocv_pack_volts[OCV_N-1]) return ocv_pack_soc[OCV_N-1];
  for (int i = 0; i < OCV_N - 1; i++) {
    if (vpack <= ocv_pack_volts[i] && vpack > ocv_pack_volts[i+1]) {
      float dv = ocv_pack_volts[i] - ocv_pack_volts[i+1];
      float ds = ocv_pack_soc[i]   - ocv_pack_soc[i+1];
      return ocv_pack_soc[i] - (ocv_pack_volts[i] - vpack) * ds / dv;
    }
  }
  return 0.0;
}

// --- Main updateSoC function ---
void updateSoC(float vpack, float current_mA, float dt_s) {

  if (!socInitialized) {
    float soc_voltage = voltageToSoC(vpack);
    if (soc_voltage == 0.0) {
      return;
    }
    currentCapacity_mAh = estimatedCapacity_mAh * (soc_voltage / 100.0f);
    socInitialized = true;
  }

  // --- 1) Coulomb counting ---
  float delta_mAh = current_mA * dt_s / 3600.0; // current in mA, dt in s
  if (delta_mAh > 0) {
    chargedToday += delta_mAh;
  }
  if (delta_mAh < 0) {
    dischargedToday -= delta_mAh;
  }

  updateCapacityLearning(current_mA, delta_mAh);

  currentCapacity_mAh += delta_mAh;

  if (abs(current_mA) < 1.0 and batteryVoltage > 13) {
    currentCapacity_mAh = estimatedCapacity_mAh;
  }

  // Clamp
  if (currentCapacity_mAh < 0.0) currentCapacity_mAh = 0.0;
  if (currentCapacity_mAh > estimatedCapacity_mAh) currentCapacity_mAh = estimatedCapacity_mAh;

  float soc_coulomb = 100.0f * (currentCapacity_mAh / estimatedCapacity_mAh);

  // --- 2) Voltage-based SoC with IR compensation ---
  const float R_internal = 0.18; // ohms, pack internal resistance (tune this)
  float current_A = current_mA / 1000.0;
  float OCV_est = vpack + current_A * R_internal; // V = Vpack + I*R

  float soc_voltage = voltageToSoC(OCV_est);

  // --- 3) Blend ---
  const float alpha = 0.02; // 2% voltage correction
  batterySoC = (1.0 - alpha) * soc_coulomb + alpha * soc_voltage;

  // Clamp
  if (batterySoC < 0.0) batterySoC = 0.0;
  if (batterySoC > 100.0) batterySoC = 100.0;

  savePersistedSocState();
}



// =======================
// Time / WiFi / AP handling
// =======================
void printResetReason() {
  esp_reset_reason_t resetReason = esp_reset_reason();
  const char *reason;

  switch (resetReason) {
    case ESP_RST_UNKNOWN: reason = "Reset reason: Unknown"; break;
    case ESP_RST_POWERON: reason = "Reset reason: Power-on"; break;
    case ESP_RST_EXT: reason = "Reset reason: External pin reset"; break;
    case ESP_RST_SW: reason = "Reset reason: Software reset via esp_restart"; break;
    case ESP_RST_PANIC: reason = "Reset reason: Panic (software crash)"; break;
    case ESP_RST_INT_WDT: reason = "Reset reason: Interrupt watchdog"; break;
    case ESP_RST_TASK_WDT: reason = "Reset reason: Task watchdog"; break;
    case ESP_RST_WDT: reason = "Reset reason: Other watchdog"; break;
    case ESP_RST_DEEPSLEEP: reason = "Reset reason: Deep sleep"; break;
    case ESP_RST_BROWNOUT: reason = "Reset reason: Brownout"; break;
    case ESP_RST_SDIO: reason = "Reset reason: SDIO"; break;
    default: reason = "Reset reason: Unknown"; break;
  }

  positionReason[0] = reason;
  positionReason[1] = reason;
  getMoveTimeString(moveTimeStr[0], sizeof(moveTimeStr[0]));
  getMoveTimeString(moveTimeStr[1], sizeof(moveTimeStr[1]));

  DEBUG_PRINTLN(moveTimeStr[0]);
  DEBUG_PRINTLN(reason);
}

bool isResetReason(int index) {
  const char* prefix = "Reset reason:";
  return strncmp(positionReason[index], prefix, strlen(prefix)) == 0;
}

bool isZeroMoveTime(int index) {
  return strcmp(moveTimeStr[index], "00:00h") == 0;
}

void connectToWiFi() {
  // AP+STA at boot
  WiFi.mode(WIFI_AP_STA);
  delay(50);

  // Configure static IP for STA
  if (!WiFi.config(staticIP, gateway, subnet, primaryDNS, secondaryDNS)) {
    DEBUG_PRINTLN("Failed to configure Static IP");
  } else {
    DEBUG_PRINTLN("Static IP configured!");
  }

  // Connect to stored STA credentials
  WiFi.begin(credentials.ssid, credentials.password);

  // Basic connection attempts without LED logic
  for (uint8_t i = 0; i < 5; i++) {
    if (WiFi.status() != WL_CONNECTED) {
      DEBUG_PRINTLN("Connecting to WiFi...");
      delay(1000);
    } else {
      DEBUG_PRINTLN("Connected to WiFi");
      DEBUG_PRINTLN(WiFi.localIP());
      localIp = WiFi.localIP();
      if (!mdnsStarted) {
        if (MDNS.begin("awnings")) {
          MDNS.addService("http", "tcp", 80);
          mdnsStarted = true;
        }
      }
      // NTP

      configTime(0, 0, "pool.ntp.org");
      const char *tz = "CET-1CEST,M3.5.0,M10.5.0/3";
      setenv("TZ", tz, 1);
      tzset();
      break;
    }
  }

  // Start AP (auto-disable after 10s if no clients)
  WiFi.softAP(apSSID, apPassword);
  apStartTime = millis();
  DEBUG_PRINT("AP IP: ");
  DEBUG_PRINTLN(WiFi.softAPIP());
}

bool checkInternet() {
  IPAddress testIP;
  return WiFi.hostByName("www.google.com", testIP);
}

void checkTime() {
  time_t now = time(nullptr);
  struct tm timeInfo;
  localtime_r(&now, &timeInfo);
  currentHour = timeInfo.tm_hour;
  currentMinute = timeInfo.tm_min;
  currentSecond = timeInfo.tm_sec;

  ensureDailyEnergyStateLoaded(timeInfo);

  DEBUG_PRINTF("Current time: %02d:%02d:%02d\n", currentHour, currentMinute, currentSecond);

  // ----- Calculate sunrise/sunset on first valid time sync or day change -----
  if (!bootUpSunCheck || lastSunCalcYearDay != timeInfo.tm_yday) {
    calculateSunTimes();
    bootUpSunCheck = true;
    if (lastSunCalcYearDay != timeInfo.tm_yday) {
      resetDailyEnergyCounters();
    }
  }

  // ----- Solar charger control -----
  if (solarChargerAuto) {
    if (!isChargerConnected() && isWithinSolarChargingWindow(now)) {
      connectCharger();
    }
    if (isChargerConnected() && !isWithinSolarChargingWindow(now)) {
      disconnectCharger();
    }
  } else {
    if (solarChargerEnabled && !isChargerConnected()) {
      connectCharger();
    }
    if (!solarChargerEnabled && isChargerConnected()) {
      disconnectCharger();
    }
  }

  if (scheduledAwnings) {
    if (!rainFlag && currentHour == morningHour && currentMinute == morningMinute && !moveUpMorning) {
      moveToPreset(morningPresetIndex, "Scheduled Morning");
      moveUpMorning = true;
    } else if (!rainFlag && currentHour == nightHour && currentMinute == nightMinute && !moveDownNight) {
      for (uint8_t i = 0; i < 2; i++) {
        moveDown(i);
        positionReason[i] = "Scheduled Night";
      }
      moveUpMorning = false;
      moveDownNight = true;
    } else if (moveUpMorning && (currentHour != morningHour || currentMinute != morningMinute)) {
      moveUpMorning = false;
    } else if (moveDownNight && (currentHour != nightHour || currentMinute != nightMinute)) {
      moveDownNight = false;
    }
  }

  syncToNextMinute();
}

bool isNTPReady() {
  time_t now = time(nullptr);
  struct tm *timeinfo = localtime(&now);
  return (now > 1609459200UL) && (timeinfo->tm_hour != 1 || timeinfo->tm_min > 0);
}

void syncToNextMinute() {
  time_t now = time(nullptr);
  struct tm *timeinfo = localtime(&now);

  unsigned long secondsLeft = 60 - timeinfo->tm_sec;
  checkTimeMillis = millis() + (secondsLeft * 1000UL);
}


void calculateSunTimes() {
  // Get current date
  time_t now = time(nullptr);
  struct tm localTime;
  localtime_r(&now, &localTime);

  int year = localTime.tm_year + 1900;
  int month = localTime.tm_mon + 1;
  int day = localTime.tm_mday;

  double transit, sunriseUTC, sunsetUTC;
  calcSunriseSunset(year, month, day, LATITUDE, LONGITUDE, transit, sunriseUTC, sunsetUTC);

  // Get local UTC offset in hours
  struct tm gm = *gmtime(&now);
  double offset = (localTime.tm_hour - gm.tm_hour) + (localTime.tm_yday - gm.tm_yday) * 24;
  // Handle wraparound
  if (offset > 12)  offset -= 24;
  if (offset < -12) offset += 24;

  double sunriseLocal = sunriseUTC + offset;
  double sunsetLocal  = sunsetUTC  + offset;

  // Wrap around 24h
  if (sunriseLocal >= 24) sunriseLocal -= 24;
  if (sunsetLocal  >= 24) sunsetLocal  -= 24;
  if (sunriseLocal < 0)  sunriseLocal += 24;
  if (sunsetLocal < 0)   sunsetLocal += 24;

  {
    struct tm sunriseTm = localTime;
    sunriseTm.tm_hour = (int)sunriseLocal;
    sunriseTm.tm_min  = (int)((sunriseLocal - sunriseTm.tm_hour) * 60);
    sunriseTm.tm_sec  = (int)((((sunriseLocal - sunriseTm.tm_hour) * 60) - sunriseTm.tm_min) * 60);
    sunriseTime = roundTimeToNearestMinute(mktime(&sunriseTm));
  }

  {
    struct tm sunsetTm = localTime;
    sunsetTm.tm_hour = (int)sunsetLocal;
    sunsetTm.tm_min  = (int)((sunsetLocal - sunsetTm.tm_hour) * 60);
    sunsetTm.tm_sec  = (int)((((sunsetLocal - sunsetTm.tm_hour) * 60) - sunsetTm.tm_min) * 60);
    sunsetTime = roundTimeToNearestMinute(mktime(&sunsetTm));
  }

  DEBUG_PRINT("Sunrise: "); DEBUG_PRINTLN(sunsetTime);

  formatTimeToHHMM(sunriseTime, sunriseStr, sizeof(sunriseStr));
  formatTimeToHHMM(sunsetTime, sunsetStr, sizeof(sunsetStr));
  formatTimeToHHMM(getChargerStartTime(), chargerStartStr, sizeof(chargerStartStr));
  formatTimeToHHMM(getChargerStopTime(), chargerStopStr, sizeof(chargerStopStr));
  sunTimesCalculatedToday = true;
  lastSunCalcYearDay = localTime.tm_yday;
  DEBUG_PRINT("Sunrise: "); DEBUG_PRINTLN(sunriseStr);
  DEBUG_PRINT("Sunset : "); DEBUG_PRINTLN(sunsetStr);
}

// Rounded HH:mm
char* hoursToString(double h, char* str) {
  int m = int(round(h * 60));
  int hr = (m / 60) % 24;
  int mn = m % 60;

  str[0] = (hr / 10) % 10 + '0';
  str[1] = (hr % 10) + '0';
  str[2] = ':';
  str[3] = (mn / 10) % 10 + '0';
  str[4] = (mn % 10) + '0';
  str[5] = '\0';
  return str;
}

// =======================
// Rain
// =======================

void checkRain() {
  checkRainMillis = currentMillis;
  rainState = digitalRead(RAIN_PIN);
  if(initialHome) {
    if (rainState == LOW) {
      if (!rainFlag) {
        rainFlag = true;
        for (uint8_t i = 0; i < 2; i++) {
        beforeRainPosition[i] = currentPosition[i];
        moveDown(i);
        positionReason[i] = "It's Raining";
      }
    }
    checkRainInterval = 300000; // check every 5 min if it started to rain
  } else {  // HIGH
      if (rainFlag) {
        rainFlag = false;
        for (uint8_t i = 0; i < 2; i++) {
          if (!moveDownNight) {
            int target = (moveUpMorning) ? 0 : beforeRainPosition[i];
            if (currentPosition[i] != target) {
              moveToPosition(i, target);
              positionReason[i] = "Stopped Raining";
            }
            moveUpMorning = false;
          } else if (currentPosition[i] != beforeRainPosition[i]) {
            moveDown(i);
            positionReason[i] = "Stopped Raining";
          }
      }
    }
    checkRainInterval = 5000;
  }
  }
  
}

// =======================
// HTTP minimal handlers
// =======================

void handleSave(AsyncWebServerRequest *request, uint8_t *data, size_t len, size_t, size_t) {
  // Placeholder in your original; keep minimal parse so it's functional
  DynamicJsonDocument json(1024);
  if (deserializeJson(json, data, len)) return;
  // Example optional fields:
  if (json.containsKey("morningHour")) morningHour = constrain((int)json["morningHour"], 0, 23);
  if (json.containsKey("morningMinute")) morningMinute = constrain((int)json["morningMinute"], 0, 59);
  if (json.containsKey("morningPresetIndex")) {
    morningPresetIndex = constrain((int)json["morningPresetIndex"], 0, PRESET_COUNT - 1);
  }
  if (json.containsKey("nightHour")) nightHour = constrain((int)json["nightHour"], 0, 23);
  if (json.containsKey("nightMinute")) nightMinute = constrain((int)json["nightMinute"], 0, 59);
  if (json.containsKey("scheduled")) scheduledAwnings = json["scheduled"];
  if (json.containsKey("automaticDayNight")) scheduledAwnings = json["automaticDayNight"];
  if (json.containsKey("rainSensorEnabled")) rainSensorEnabled = json["rainSensorEnabled"];
  if (json.containsKey("solarChargerStartOffsetMin")) {
    solarChargerStartOffsetMin = constrain((int)json["solarChargerStartOffsetMin"], 0, 360);
  }
  if (json.containsKey("solarChargerStopOffsetMin")) {
    solarChargerStopOffsetMin = constrain((int)json["solarChargerStopOffsetMin"], 0, 360);
  }
  if (json.containsKey("solarChargerAuto")) {
    solarChargerAuto = json["solarChargerAuto"];
  }
  if (json.containsKey("output12VEnabled")) {
    bool currentOutput12V = !digitalRead(OUTPUT_12V_EN);
    output12VEnabled = json["output12VEnabled"];
    if (currentOutput12V != output12VEnabled) {
      if (output12VEnabled) {
        enableOutput12V();
      } else {
        moveFlag[0] = false;
        moveFlag[1] = false;
        disableOutput12V(false);
      }
    }
  }

  if (json.containsKey("solarChargerEnabled")) {
    bool newSolarChargerEnabled = json["solarChargerEnabled"];
    solarChargerEnabled = newSolarChargerEnabled;
  }
  if (json.containsKey("motorSpeed0")) {
    int nextSpeed0 = (int)json["motorSpeed0"];
    if (nextSpeed0 < 1) nextSpeed0 = 1;
    if (nextSpeed0 > 300000) nextSpeed0 = 300000;
    motorSpeed[0] = nextSpeed0;
    stepper[0]->setSpeedInHz(motorSpeed[0]);
  }
  if (json.containsKey("motorSpeed1")) {
    int nextSpeed1 = (int)json["motorSpeed1"];
    if (nextSpeed1 < 1) nextSpeed1 = 1;
    if (nextSpeed1 > 300000) nextSpeed1 = 300000;
    motorSpeed[1] = nextSpeed1;
    stepper[1]->setSpeedInHz(motorSpeed[1]);
  }
  formatTimeToHHMM(getChargerStartTime(), chargerStartStr, sizeof(chargerStartStr));
  formatTimeToHHMM(getChargerStopTime(), chargerStopStr, sizeof(chargerStopStr));
  time_t now = time(nullptr);
  if (solarChargerAuto) {
    if (!isChargerConnected() && isWithinSolarChargingWindow(now)) {
      connectCharger();
    }
    if (isChargerConnected() && !isWithinSolarChargingWindow(now)) {
      disconnectCharger();
    }
  } else {
    if (solarChargerEnabled && !isChargerConnected()) {
      connectCharger();
    }
    if (!solarChargerEnabled && isChargerConnected()) {
      disconnectCharger();
    }
  }
  savePersistedConfig();
  request->send(200, "text/plain", "Changes Applied");
}


void handleSetEnd(AsyncWebServerRequest *request, uint8_t *data, size_t len, size_t index, size_t total) {
  StaticJsonDocument<128> json;
  DeserializationError err = deserializeJson(json, data, len);
  if (err) {
    request->send(400, "text/plain", "Bad JSON");
    return;
  }

  const char *buttonId = json["buttonId"];
  if (!buttonId || strlen(buttonId) == 0) {
    request->send(400, "text/plain", "Missing buttonId");
    return;
  }

  char indexChar = buttonId[strlen(buttonId) - 1];
  if (indexChar != '0' && indexChar != '1') {
    request->send(400, "text/plain", "Invalid motor index");
    return;
  }

  uint8_t i = indexChar == '0' ? 0 : 1;
  const char *action = json["action"] | "";
  bool startAction = strcmp(action, "start") == 0 || strstr(buttonId, "end") != NULL;
  bool saveAction = strcmp(action, "save") == 0 || strstr(buttonId, "save") != NULL;

  if (!startAction && !saveAction) {
    request->send(400, "text/plain", "Unknown action");
    return;
  }

  if (startAction && !saveAction) {
    settingEnd[i] = true;
    request->send(200, "text/plain", "End position setup started");
    return;
  }

  if (stepper[i]->getCurrentPosition() == 0) {
    request->send(400, "text/plain", "Move awning away from home before saving");
    return;
  }

  downPosition[i] = stepper[i]->getCurrentPosition();
  windowHeight[i] = downPosition[i];
  settingEnd[i] = false;
  savePersistedConfig();
  request->send(200, "text/plain", "End position saved");
}

void handlePreset(AsyncWebServerRequest *request, uint8_t *data, size_t len, size_t, size_t) {
  StaticJsonDocument<256> json;
  if (deserializeJson(json, data, len)) {
    request->send(400, "text/plain", "Bad JSON");
    return;
  }

  const char *action = json["action"] | "";
  int presetIndex = json["presetIndex"] | -1;
  if (presetIndex < 0 || presetIndex >= PRESET_COUNT) {
    request->send(400, "text/plain", "Invalid preset");
    return;
  }

  if (strcmp(action, "apply") == 0) {
    if (rainFlag) {
      request->send(409, "text/plain", "Cannot apply a preset while rain protection is active");
      return;
    }
    if (!moveToPreset(presetIndex, "Preset")) {
      request->send(409, "text/plain", "Home both awnings and wait for movement to finish first");
      return;
    }
    request->send(200, "text/plain", "Moving to preset");
    return;
  }

  if (strcmp(action, "save") == 0) {
    if (!initialHome || homeFlag || moveFlag[0] || moveFlag[1]) {
      request->send(409, "text/plain", "Home both awnings and wait for movement to finish before saving");
      return;
    }
    for (uint8_t i = 0; i < AWNING_COUNT; i++) {
      int position = stepper[i]->getCurrentPosition();
      int percent = (int)(((int64_t)position * 100) / windowHeight[i]);
      presets[presetIndex].position[i] = constrain(percent, 0, 100);
    }
    const char *name = json["name"] | "";
    if (strlen(name) > 0) {
      strncpy(presets[presetIndex].name, name, sizeof(presets[presetIndex].name) - 1);
      presets[presetIndex].name[sizeof(presets[presetIndex].name) - 1] = '\0';
    }
    savePersistedConfig();
    request->send(200, "text/plain", "Preset saved");
    return;
  }

  request->send(400, "text/plain", "Unknown preset action");
}


void handleSaveWifi(AsyncWebServerRequest *request, uint8_t *data, size_t len, size_t, size_t) {
  StaticJsonDocument<256> json;
  if (deserializeJson(json, data, len)) return;
  const char *ss = json["ssid"] | "";
  const char *pw = json["password"] | "";
  strncpy(credentials.ssid, ss, ssidMaxSize);
  credentials.ssid[ssidMaxSize - 1] = 0;
  strncpy(credentials.password, pw, passwordMaxSize);
  credentials.password[passwordMaxSize - 1] = 0;
  saveWiFiCredentials();
  request->send(200, "text/plain", "WiFi Saved");
  connectToWiFi();
  
}

void handleSetupDrivers(AsyncWebServerRequest *request, uint8_t *data, size_t len, size_t index, size_t total) {
  StaticJsonDocument<128> json;
  DeserializationError error = deserializeJson(json, data, len);
  if (error) {
    request->send(400, "text/plain", "Invalid JSON");
    return;
  }

  int stallValue = json["stall_value"] | -1;
  int lowStallValue = json["low_stall_value"] | -1;
  int stallMinSpeed = json["stall_min_speed"] | -1;
  int maxSpeed = json["max_speed"] | -1;
  int maxSpeed0 = json["max_speed0"] | -1;
  int maxSpeed1 = json["max_speed1"] | -1;
  int acc = json["acceleration"] | -1;

  if (lowStallValue >= 0 && lowStallValue <= 255) {
    LOW_STALL_VALUE = lowStallValue;
  }

  if (stallValue >= 0 && stallValue <= 255) {
    STALL_VALUE = stallValue;
  }

  if (stallMinSpeed >= 1 && stallMinSpeed <= 1048575) {
    STALL_MIN_SPEED = stallMinSpeed;
  }

  if (maxSpeed >= 1 && maxSpeed <= 300000) {
    motorSpeed[0] = maxSpeed;
    motorSpeed[1] = maxSpeed;
    stepper[0]->setSpeedInHz(motorSpeed[0]);
    stepper[1]->setSpeedInHz(motorSpeed[1]);
  }

  if (maxSpeed0 >= 1 && maxSpeed0 <= 300000) {
    motorSpeed[0] = maxSpeed0;
    stepper[0]->setSpeedInHz(motorSpeed[0]);
  }

  if (maxSpeed1 >= 1 && maxSpeed1 <= 300000) {
    motorSpeed[1] = maxSpeed1;
    stepper[1]->setSpeedInHz(motorSpeed[1]);
  }

  if (acc >= 1 && acc <= 300000) {
    acceleration = acc;
    stepper[0]->setAcceleration(acceleration);
    stepper[1]->setAcceleration(acceleration);
  }

  setupDrivers();
  savePersistedConfig();

  char response[140];
  snprintf(response, sizeof(response),
           "STALL_VALUE = %d\nSTALL_MIN_SPEED = %d\nLOW_STALL_VALUE = %d\nspeed0 = %lu\nspeed1 = %lu\nacceleration = %lu",
           STALL_VALUE, STALL_MIN_SPEED, LOW_STALL_VALUE,
           (unsigned long)motorSpeed[0], (unsigned long)motorSpeed[1], (unsigned long)acceleration);

  request->send(200, "text/plain", response);
}

void handleSetupInas(AsyncWebServerRequest *request, uint8_t *data, size_t len, size_t index, size_t total) {
  StaticJsonDocument<128> json;
  DeserializationError error = deserializeJson(json, data, len);
  if (error) {
    request->send(400, "text/plain", "Invalid JSON");
    return;
  }

  float shunt_bat = json["shunt_bat"] | -1.0;
  float shunt_pv = json["shunt_pv"] | -1.0;

  if (shunt_bat > 0.0 && shunt_bat <= 1.0) {
    R_SHUNT_BAT = shunt_bat;
  }

  if (shunt_pv > 0.0 && shunt_pv <= 1.0) {
    R_SHUNT_PV = shunt_pv;
  }
  if (shunt_bat > 0 || shunt_pv > 0) {
    inaSetup();
  }

  savePersistedConfig();

  char response[100];
  snprintf(response, sizeof(response),
           "R_SHUNT_BAT = %f\nR_SHUNT_PV = %f",
           R_SHUNT_BAT, R_SHUNT_PV);

  request->send(200, "text/plain", response);
}


// =======================
// Main loop
// =======================
void loop() {
  currentMillis = millis();


  if (currentMillis - inaTriggerMillis >= inaPeriod) {
    inaTrigger();
  }

  if (inaMeasuring && (currentMillis - inaReadMillis >= 9)) {
    inaRead();
  }

  if (currentMillis - lastAPIrequestMillis >= lastAPIrequestTimeout) {
    inaPeriod = 20000;
    previousInaPeriod = inaPeriod;
  }

  // // AP auto-off after 20s if no clients
  if (apModeEnabled && (currentMillis - apStartTime >= apTimeout)) {
    uint8_t connectedDevices = WiFi.softAPgetStationNum();
    if (connectedDevices == 0) {
      DEBUG_PRINTLN("No devices connected to AP, disabling AP mode");
      WiFi.softAPdisconnect(true);
      apModeEnabled = false;
    }
  }

  if (!timeSynced && isNTPReady()) {
    checkTime();  // Align to next HH:MM:00
    timeSynced = true;
    for (uint8_t i = 0; i < 2; i++) {
      if (isZeroMoveTime(i) && isResetReason(i)) {
        getMoveTimeString(moveTimeStr[i], sizeof(moveTimeStr[i]));
      }
    }
  }

  if (lowVoltage) {
    for(uint8_t i = 0; i < 2; i++) {
      if (stepper[i]->isRunning() || moveFlag[i]) {
        stop(i);
        positionReason[i] = "Low Voltage Stop";
      }
    }
    disableOutput12V(true);
  }

  if (!lowVoltage || serialDebug) {
    checkPreemptiveFold();
    if (currentMillis >= checkTimeMillis) {
      if (!chargerInitialized && !moveFlag[0] && !moveFlag[1]) {
        initCharger();
      }
      if (!checkInternet()) {
        connectToWiFi();
      }
      if (!timeSynced && isNTPReady()) {
        timeSynced = true;
      }
      if (timeSynced || isNTPReady()) {
        checkTime();
      }
    }

    if (rainSensorEnabled && currentMillis - checkRainMillis >= checkRainInterval) {
      checkRain();
    }

    checkMotors();
  }
}
