mprat99/IoT_Awnings/(commit log)

2025-10-12 added electronics schematic
2026-01-24 Add preemptive fold logic and adjust low voltage thresholds
2026-04-01 Add solar charger offset controls
2026-04-01 Add WiFi scanning functionality and update solar charger status handling
2026-04-12 feat: Enhance solar charger functionality and UI updates
    - Updated index.html to display estimated battery capacity alongside current capacity.
    - Added a toggle switch for solar mode (auto/manual) in the UI, with corresponding text updates.
    - Refactored JavaScript code to streamline DOM updates using a helper function.
    - Integrated solar charger auto mode logic in the JavaScript, allowing for dynamic control based on charger connection status.
    - Enhanced CSS for better styling of the new solar mode switch and improved button interactions.
    - Updated Arduino code to support new solar charger auto mode, including persistent configuration storage for user settings.
    - Implemented functions to loa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
2026-05-16 feat: Add speed control panel for awnings and update motor speed handling
